krlnokrl/soteria-hardware-wallet/README.md

# soteria-hardware-wallet
Soteria hardware wallet source files (samd21 based wallet)

Feel free to contribute to the project!
This is still a work in progress, there are no releases at the moment. Use at your onw risk.

### DO NOT use this code with real money! There is guarantee to be bugs!
