krlnokrl/soteria-hardware-wallet/hardware/README.md

EasyEDA project for PCB
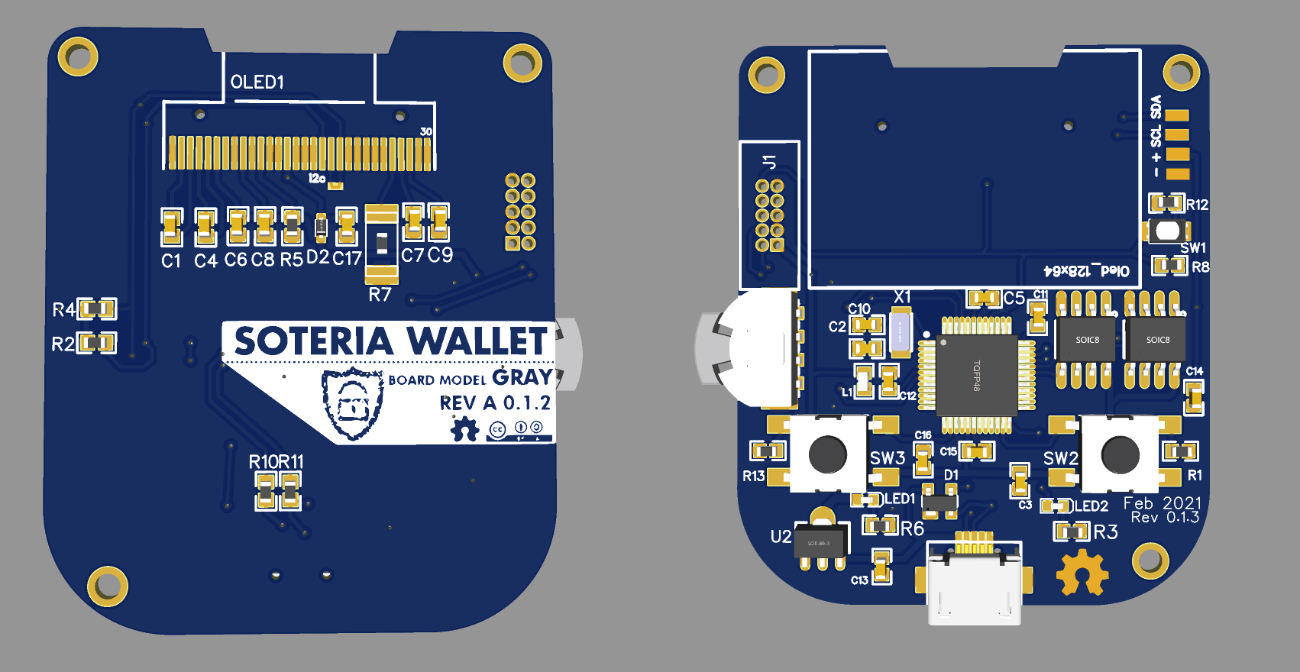
[picture p1: hardware/3d.png]
3d render 3D Render
