krlnokrl/soteria-hardware-wallet/hardware/SoteriaPCBBack.png

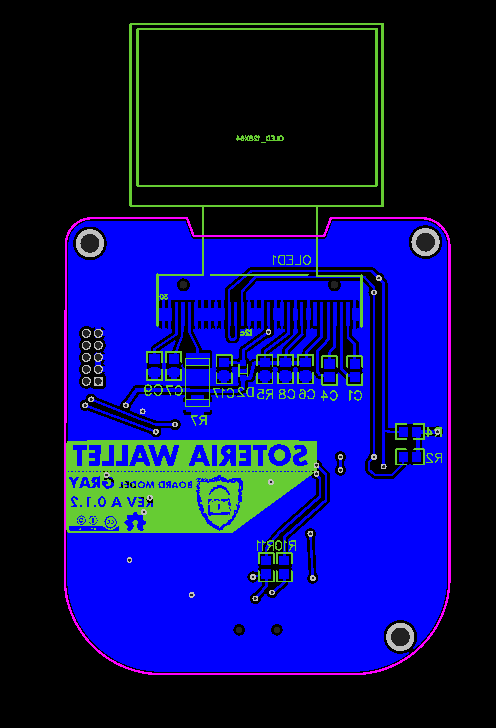
hardware/SoteriaPCBBack.png
