krlnokrl/soteria-hardware-wallet/hardware/SoteriaPCBFront.png

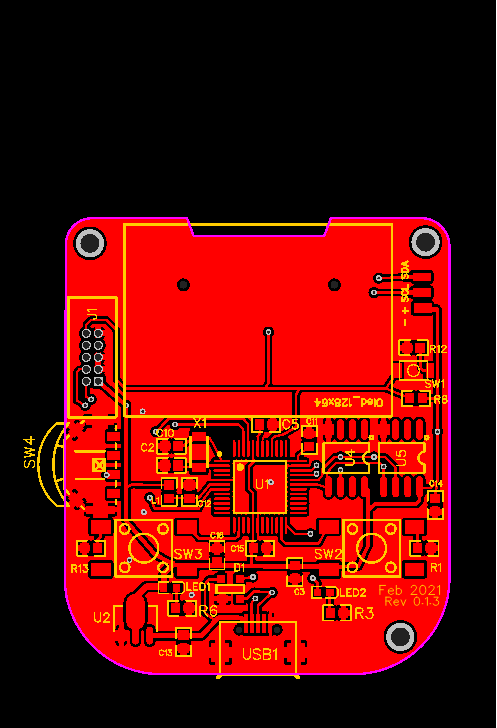
hardware/SoteriaPCBFront.png
