krlnokrl/soteria-hardware-wallet/hardware/BOM_SoteriaWallet_2021-11-10.csv

ID | Name | Designator | Footprint | Quantity | Manufacturer Part | Manufacturer | Supplier | Supplier Part
1 | 27 | R10,R11 | 603 | 2 | RN731JTTD27R0B25 | KOA Speer Elec | LCSC | C186358
2 | 390K | R7 | 2010 | 1 | AECR2010F390KK9 | ResistorToday | LCSC | C351780
3 | SLLB520200 | SW4 | SW-TH_SLLB520200 | 1 | SLLB520200 | ALPS Electric | LCSC | C351183
4 | GT24C64A-2GLI-TR | U5 | SOIC-8_150MIL | 1 | GT24C64A-2GLI-TR | Giantec | LCSC | C239142
5 | FC-F1005BK-470G5 | LED1,LED2 | LED-0402 | 2 | FC-F1005BK-470G5 | NATIONSTAR | LCSC | C130724
6 | ATSAMD21G18A-AU | U1 | TQFP-48_7X7X05P | 1 | ATSAMD21G18A-AU | MICROCHIP | LCSC | C78624
7 | Murata | C11,C15,C3,C12,C13,C16,C14 | 603 | 7 | GCM188R71C104KA37D | Murata Electronics | LCSC | C184760
8 | 2.2uF | C17,C1,C4,C6,C8,C9,C7,C5 | 603 | 8 | CGA3E1X7R0J225M080AC | TDK | LCSC | C194114
9 | VG-2864KSWEG01 | OLED1 | OLED-0.96-12864 | 1 | VG-2864KSWEG01 |  | LCSC | C194313
10 | 15pF | C2,C10 | 603 | 2 | GRM1885C2A150JA01D | MuRata | LCSC | C97715
11 | 10K | R2,R5,R4,R1,R8,R13 | 603 | 6 | RK73B1JTTD103J | KOA | LCSC | C159891
12 | 1N4148WT_C779742 | D2 | SOD-523_L1.2-W0.8-LS1.6-RD | 1 | 1N4148WT | ZRE | LCSC | C779742
13 | KXT311LHS | SW1 | KEY-3.0X2.0X0.6 | 1 | KXT311LHS | C&K | LCSC | C221820
14 | LM1117F-3.3 | U2 | SOT-89(SOT-89-3) | 1 | LM1117F-3.3 | HTC | LCSC | C126019
15 | PRTR5V0U2X | D1 | SOT-143 | 1 | PRTR5V0U2X | Yenji Elec | LCSC | C330092
16 | Micro USB 母座 5P | USB1 | MICRO-USB-16 | 1 | - | Boom Precision Elec | LCSC | C21377
17 | 330 | R6,R12,R3 | 603 | 3 | RK73B1JTTD331J | KOA | LCSC | C131709
18 | SWDSAM | J1 | 3220-10-0100-00 | 1 | ?
19 | 470Ω | L1 | 603 | 1 | BLM18PG471SN1D | MuRata | LCSC | C97853
20 | KAN0642F-0431B1-C15 | SW2,SW3 | KEY-TOUCH-SMD-6.0*6.0*H | 2 | KAN0642F-0431B1-C15 | GANGYUAN | LCSC | C231682
21 | 32.768KHz | X1 | SMD-3215_2P_CLEAN | 1 | YST310S32.768KHz12.5pF10ppm | YXC | LCSC | C94279
22 | ATECC508A-SSHDA-T | U4 | SOIC-8_150MIL | 1 | ATECC508A-SSHDA-T | MICROCHIP | LCSC | C79914
