krlnokrl/soteria-hardware-wallet/(threads)

Thread 1 (2021-11-10):

WIP - all components placed on one side

krlnokrl, 2021-11-10:
Description:
It would be desirable to place all the components(except the oled) on the top side of the pcb.
This way the components could be soldered at once on a hotplate.

Action:
Requires optimization of component placement and traces. A few resistors and capacitors can be removed to make space. Most traces should be shortened and improved.

* Would be nice if the micro usb port could also be replaced by USB-C
