krlnokrl/soteria-hardware-wallet/(commit log)

2021-11-10 initial poc BOM
    [BOM_SoteriaWallet_2021-11-10.csv]
2021-11-10 Add 3d rendering of pcb+components
2021-11-10 Add schematic files
